dj140/X_driver/bldc_motor_cntroller/bldc_motor_cntroller.kicad_pcb

## KiCad design bldc_motor_cntroller/bldc_motor_cntroller.kicad_pcb (2021-05-30)

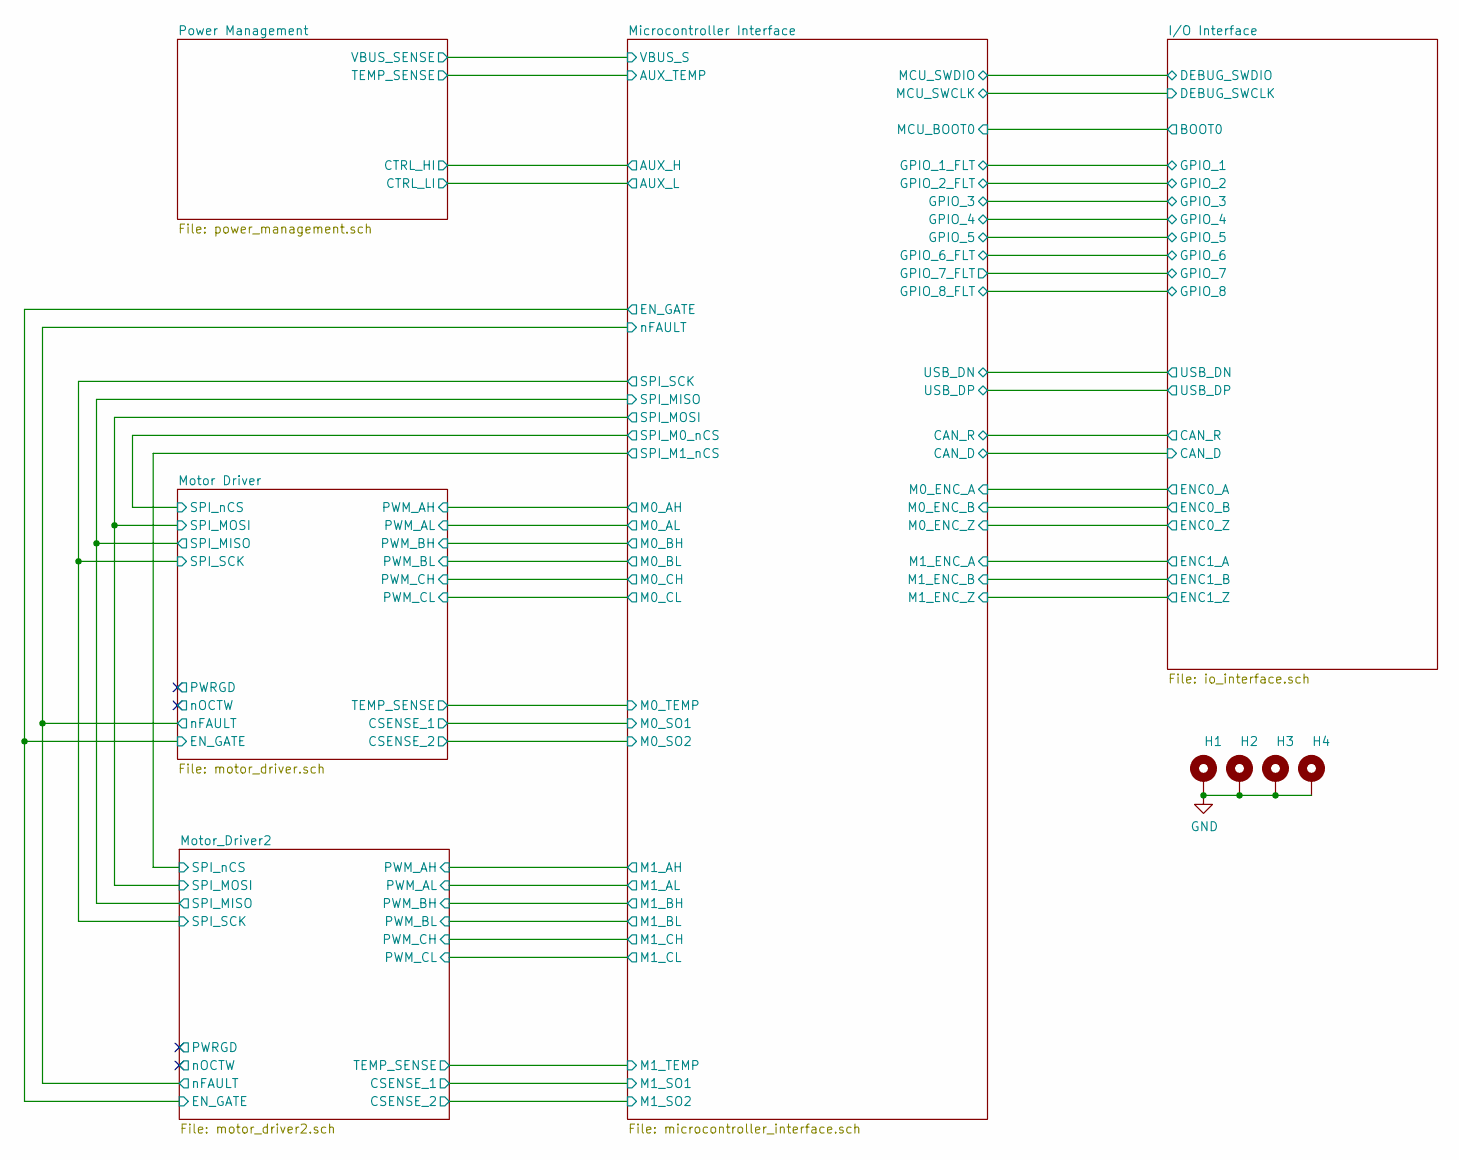
[picture p1: schematic bldc_motor_cntroller.sch, X_Odrive]

Parts:
H1, H2, H3, H4: MountingHole_Pad; MountingHole_2.2mm_M2_Pad_Via

Connections:
GND: H1.1, H2.1, H3.1, H4.1; also elsewhere on the board

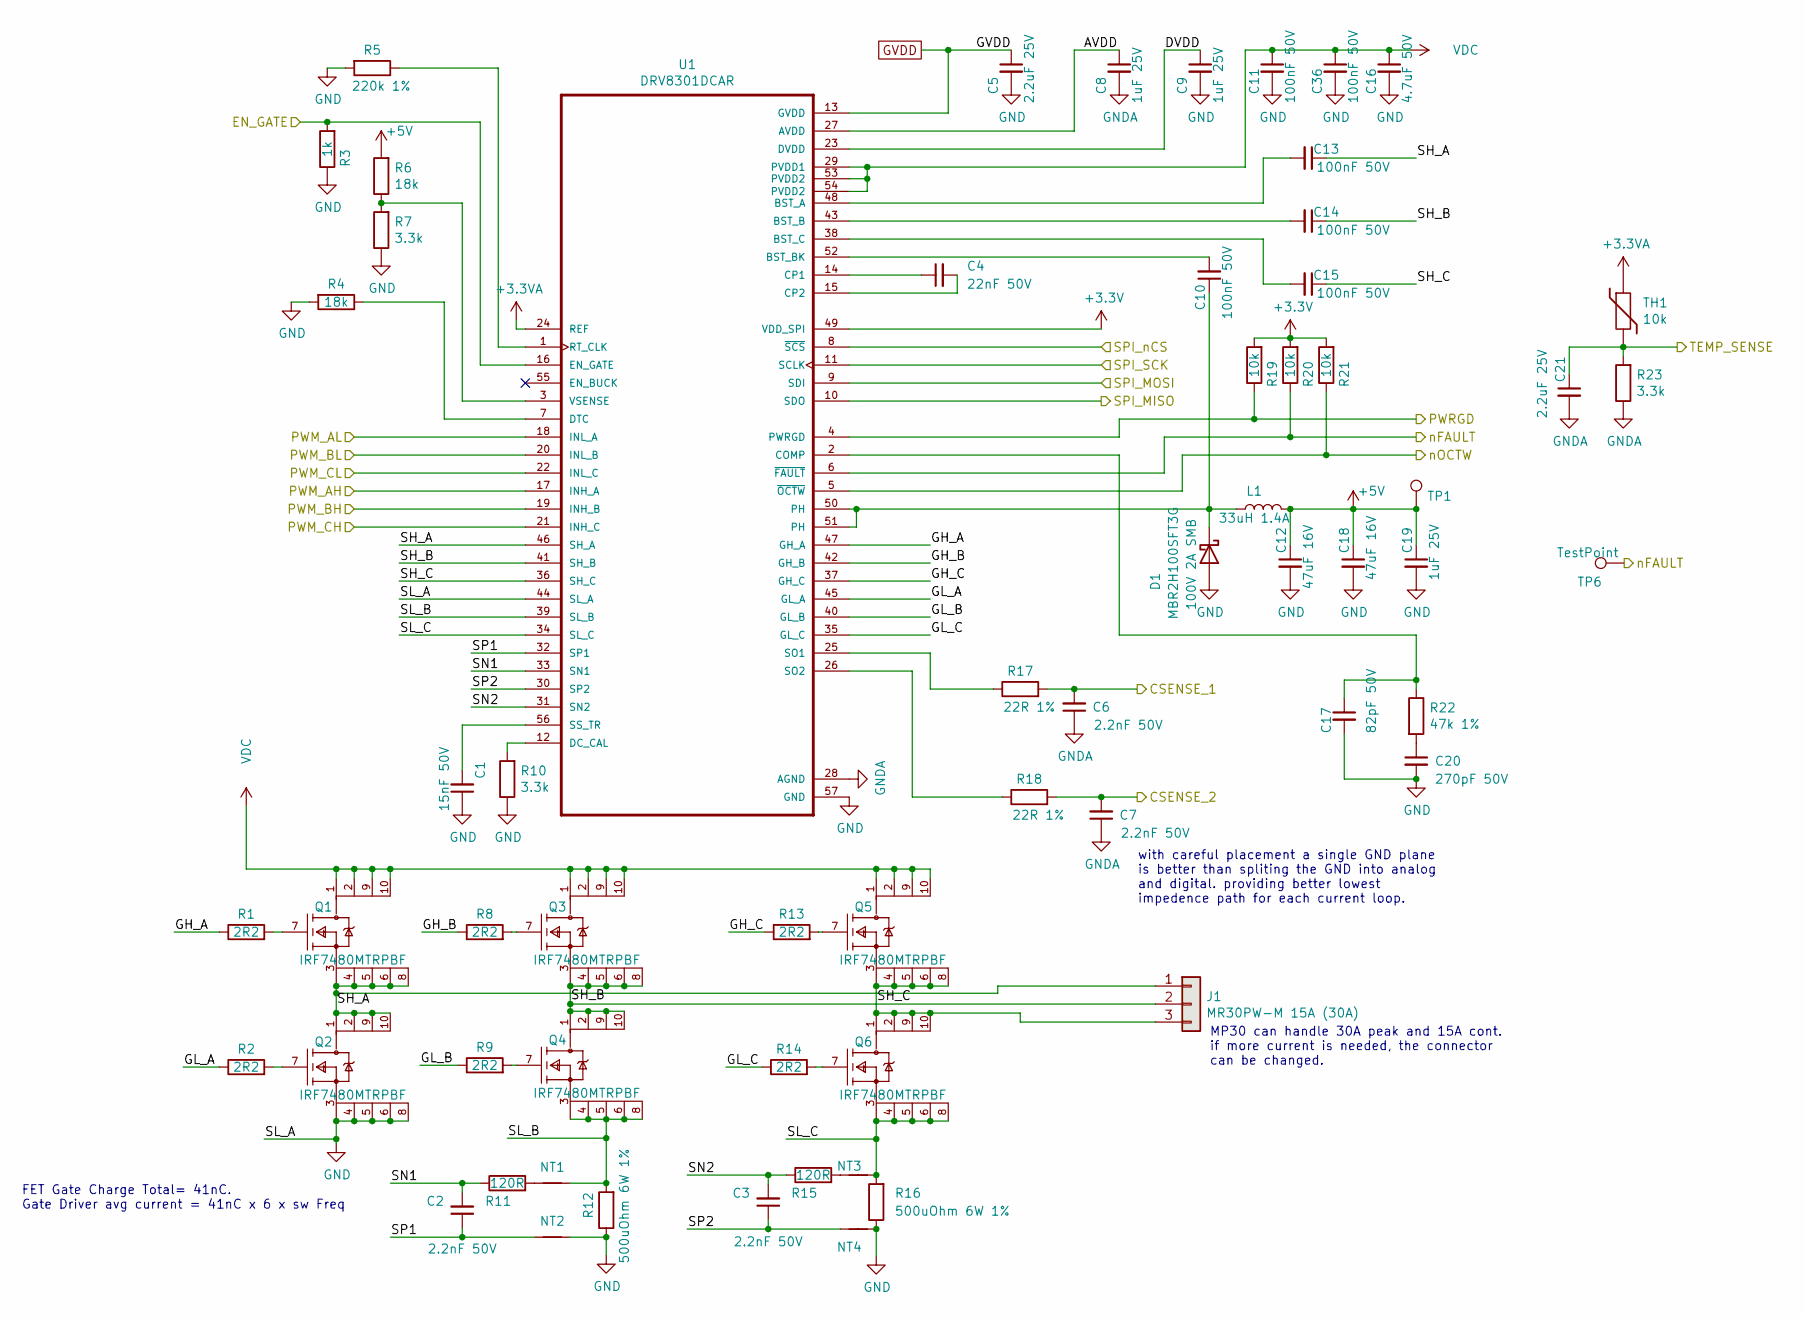
[picture p2: schematic motor_driver.sch, Motor Driver]

Parts:
C1: 15nF 50V; C_0402_1005Metric; MPN GCM155R71E153JA55D
C2, C3, C6, C7: 2.2nF 50V; C_0402_1005Metric; MPN C0402C222J3GEC7411; LCSC Part # C1531
C4: 22nF 50V; C_0402_1005Metric; MPN C0402C223K5REC7411; LCSC Part # C1532
C5, C21: 2.2uF 25V; C_0402_1005Metric; MPN GRM155C81E225KE11D; LCSC Part # C12530
C8, C9, C19: 1uF 25V; C_0402_1005Metric; MPN GMK105CC6105MV-F; LCSC Part # C52923
C10, C13, C14, C15: 100nF 50V; C_0402_1005Metric; MPN GCM155L8EH104KE07D
C11, C36: 100nF 50V; C_0402_1005Metric; MPN GRM155R62A104KE14D
C12, C18: 47uF 16V; C_1206_3216Metric; MPN GRM32EC81C476KE15L; LCSC Part # C96123
C16: 4.7uF 50V; C_1206_3216Metric; MPN HMK325C7475KN-TE
C17: 82pF 50V; C_0402_1005Metric; MPN VJ0402A820JXACW1BC
C20: 270pF 50V; C_0402_1005Metric; MPN GRM1555C1H271FA01D
D1: 100V 2A SMB; D_SOD-123F; MPN MBR2H100SFT3G
J1: MR30PW-M 15A (30A); AMASS_MR30PW-M_1x03_P3.50mm_Horizontal
L1: 33uH 1.4A; L_Taiyo-Yuden_NR-60xx; MPN NR6045T330M
NT1, NT2, NT3, NT4: Net-Tie_2; NetTie-2_SMD_Pad0.5mm
Q1, Q2, Q3, Q4, Q5, Q6: IRF7480MTRPBF; Infineon-MG-WDSON-8-05_2016-901-MFG; mouser part number 942-IRF7480MTRPBF; digikey description MOSFET N-CH 40V 217A DIRECTFET
R1, R2, R8, R9, R13, R14: 2R2; R_0402_1005Metric; MPN CRCW04022R20FKEDC
R3: 1k; R_0402_1005Metric; MPN ERJ-2RKF1001X; LCSC Part # C11702
R4, R6: 18k; R_0402_1005Metric; MPN CRCW040218K0FKED; LCSC Part # C25762
R5: 220k 1%; R_0402_1005Metric; MPN CRCW0402220KFKEDC; LCSC Part # C25767
R7, R10, R23: 3.3k; R_0402_1005Metric; MPN CRCW04023K30FKEDC; LCSC Part # C25890
R11, R15: 120R; R_0402_1005Metric; MPN ERJ-2RKF1200X; LCSC Part # C25079
R12, R16: 500uOhm 6W 1%; R_2512_6332Metric; MPN CSS2H-2512R-L500F
R17, R18: 22R 1%; R_0402_1005Metric; MPN CRCW040222R0FKEDC; LCSC Part # C25092
R19, R20, R21: 10k; R_0402_1005Metric; MPN CRCW040210K0FKEDC; LCSC Part # C25744
R22: 47k 1%; R_0402_1005Metric; MPN CRGP0402F47K; LCSC Part # C25792
TH1: 10k; R_0402_1005Metric; MPN CRCW040210K0FKEDC
TP1, TP6: TestPoint; TestPoint_Pad_D1.0mm
U1: DRV8301DCAR; DRV8301DCA; MPN DRV8301DCAR

Connections:
+3.3VA: TH1.1, U1.24 (REF); also elsewhere on the board
+3V3: R19.2, R20.2, R21.2, U1.49 (VDD_SPI); also elsewhere on the board
+5V: C12.1, C18.1, C19.1, L1.2, R6.2, TP1.1; also elsewhere on the board
/Microcontroller Interface/EN_GATE: R3.2, U1.16 (EN_GATE); also elsewhere on the board
/Microcontroller Interface/M0_AH: U1.17 (INH_A); also elsewhere on the board
/Microcontroller Interface/M0_AL: U1.18 (INL_A); also elsewhere on the board
/Microcontroller Interface/M0_BH: U1.19 (INH_B); also elsewhere on the board
/Microcontroller Interface/M0_BL: U1.20 (INL_B); also elsewhere on the board
/Microcontroller Interface/M0_CH: U1.21 (INH_C); also elsewhere on the board
/Microcontroller Interface/M0_CL: U1.22 (INL_C); also elsewhere on the board
/Microcontroller Interface/M0_TEMP: C21.1, R23.2, TH1.2; also elsewhere on the board
/Microcontroller Interface/SPI_M0_nCS: U1.8 (~SCS~); also elsewhere on the board
/Microcontroller Interface/SPI_MISO: U1.10 (SDO); also elsewhere on the board
/Microcontroller Interface/SPI_MOSI: U1.9 (SDI); also elsewhere on the board
/Microcontroller Interface/SPI_SCK: U1.11 (SCLK); also elsewhere on the board
/Microcontroller Interface/nFAULT: R20.1, TP6.1, U1.6 (~FAULT~); also elsewhere on the board
/Motor Driver/AVDD: C8.1, U1.27 (AVDD)
/Motor Driver/CSENSE_1: C6.2, R17.2; also elsewhere on the board
/Motor Driver/CSENSE_2: C7.2, R18.2; also elsewhere on the board
/Motor Driver/DVDD: C9.1, U1.23 (DVDD)
/Motor Driver/GH_A: R1.1, U1.47 (GH_A)
/Motor Driver/GH_B: R8.1, U1.42 (GH_B)
/Motor Driver/GH_C: R13.1, U1.37 (GH_C)
/Motor Driver/GL_A: R2.1, U1.45 (GL_A)
/Motor Driver/GL_B: R9.1, U1.40 (GL_B)
/Motor Driver/GL_C: R14.1, U1.35 (GL_C)
/Motor Driver/PWRGD: R19.1, U1.4 (PWRGD)
/Motor Driver/SH_A: C13.1, J1.1, Q1.3 (S), Q1.4 (S), Q1.5 (S), Q1.6 (S), Q1.8 (S), Q2.1 (D), Q2.2 (D), Q2.9 (D), Q2.10 (D), U1.46 (SH_A)
/Motor Driver/SH_B: C14.1, J1.2, Q3.3 (S), Q3.4 (S), Q3.5 (S), Q3.6 (S), Q3.8 (S), Q4.1 (D), Q4.2 (D), Q4.9 (D), Q4.10 (D), U1.41 (SH_B)
/Motor Driver/SH_C: C15.1, J1.3, Q5.3 (S), Q5.4 (S), Q5.5 (S), Q5.6 (S), Q5.8 (S), Q6.1 (D), Q6.2 (D), Q6.9 (D), Q6.10 (D), U1.36 (SH_C)
/Motor Driver/SL_B: NT1.2, Q4.3 (S), Q4.4 (S), Q4.5 (S), Q4.6 (S), Q4.8 (S), R12.2, U1.39 (SL_B)
/Motor Driver/SL_C: NT3.2, Q6.3 (S), Q6.4 (S), Q6.5 (S), Q6.6 (S), Q6.8 (S), R16.2, U1.34 (SL_C)
/Motor Driver/SN1: C2.2, R11.1, U1.33 (SN1)
/Motor Driver/SN2: C3.2, R15.1, U1.31 (SN2)
/Motor Driver/SP1: C2.1, NT2.1, U1.32 (SP1)
/Motor Driver/SP2: C3.1, NT4.1, U1.30 (SP2)
/Motor Driver/nOCTW: R21.1, U1.5 (~OCTW~)
GND: C1.1, C5.2, C6.1, C7.1, C8.2, C9.2, C11.2, C12.2, C16.2, C17.2, C18.2, C19.2, C20.2, C21.2, C36.2, D1.2 (A), NT2.2, NT4.2, Q2.3 (S), Q2.4 (S), Q2.5 (S), Q2.6 (S), Q2.8 (S), R3.1, R4.2, R5.2, R7.1, R10.1, R12.1, R16.1, R23.1, U1.28 (AGND), U1.44 (SL_A), U1.57 (GND), U1.V; also elsewhere on the board
GVDD: C5.1, U1.13 (GVDD); also elsewhere on the board
unnamed: C1.2, U1.56 (SS_TR)
unnamed: C4.1, U1.14 (CP1)
unnamed: C4.2, U1.15 (CP2)
unnamed: C10.1, D1.1 (K), L1.1, U1.50 (PH), U1.51 (PH)
unnamed: C10.2, U1.52 (BST_BK)
unnamed: C13.2, U1.48 (BST_A)
unnamed: C14.2, U1.43 (BST_B)
unnamed: C15.2, U1.38 (BST_C)
unnamed: C17.1, R22.1, U1.2 (COMP)
unnamed: C20.1, R22.2
unnamed: NT1.1, R11.2
unnamed: NT3.1, R15.2
unnamed: Q1.7 (G), R1.2
unnamed: Q2.7 (G), R2.2
unnamed: Q3.7 (G), R8.2
unnamed: Q4.7 (G), R9.2
unnamed: Q5.7 (G), R13.2
unnamed: Q6.7 (G), R14.2
unnamed: R4.1, U1.7 (DTC)
unnamed: R5.1, U1.1 (RT_CLK)
unnamed: R6.1, R7.2, U1.3 (VSENSE)
unnamed: R10.2, U1.12 (DC_CAL)
unnamed: R17.1, U1.25 (SO1)
unnamed: R18.1, U1.26 (SO2)
VDC: C11.1, C16.1, C36.1, Q1.1 (D), Q1.2 (D), Q1.9 (D), Q1.10 (D), Q3.1 (D), Q3.2 (D), Q3.9 (D), Q3.10 (D), Q5.1 (D), Q5.2 (D), Q5.9 (D), Q5.10 (D), U1.29 (PVDD1), U1.53 (PVDD2), U1.54 (PVDD2); also elsewhere on the board

Notes on the sheet:
with careful placement a single GND plane is better than spliting the GND into analog and digital. providing better lowest impedence path for each current loop.
FET Gate Charge Total= 41nC. Gate Driver avg current = 41nC x 6 x sw Freq
MP30 can handle 30A peak and 15A cont. if more current is needed, the connector can be changed.

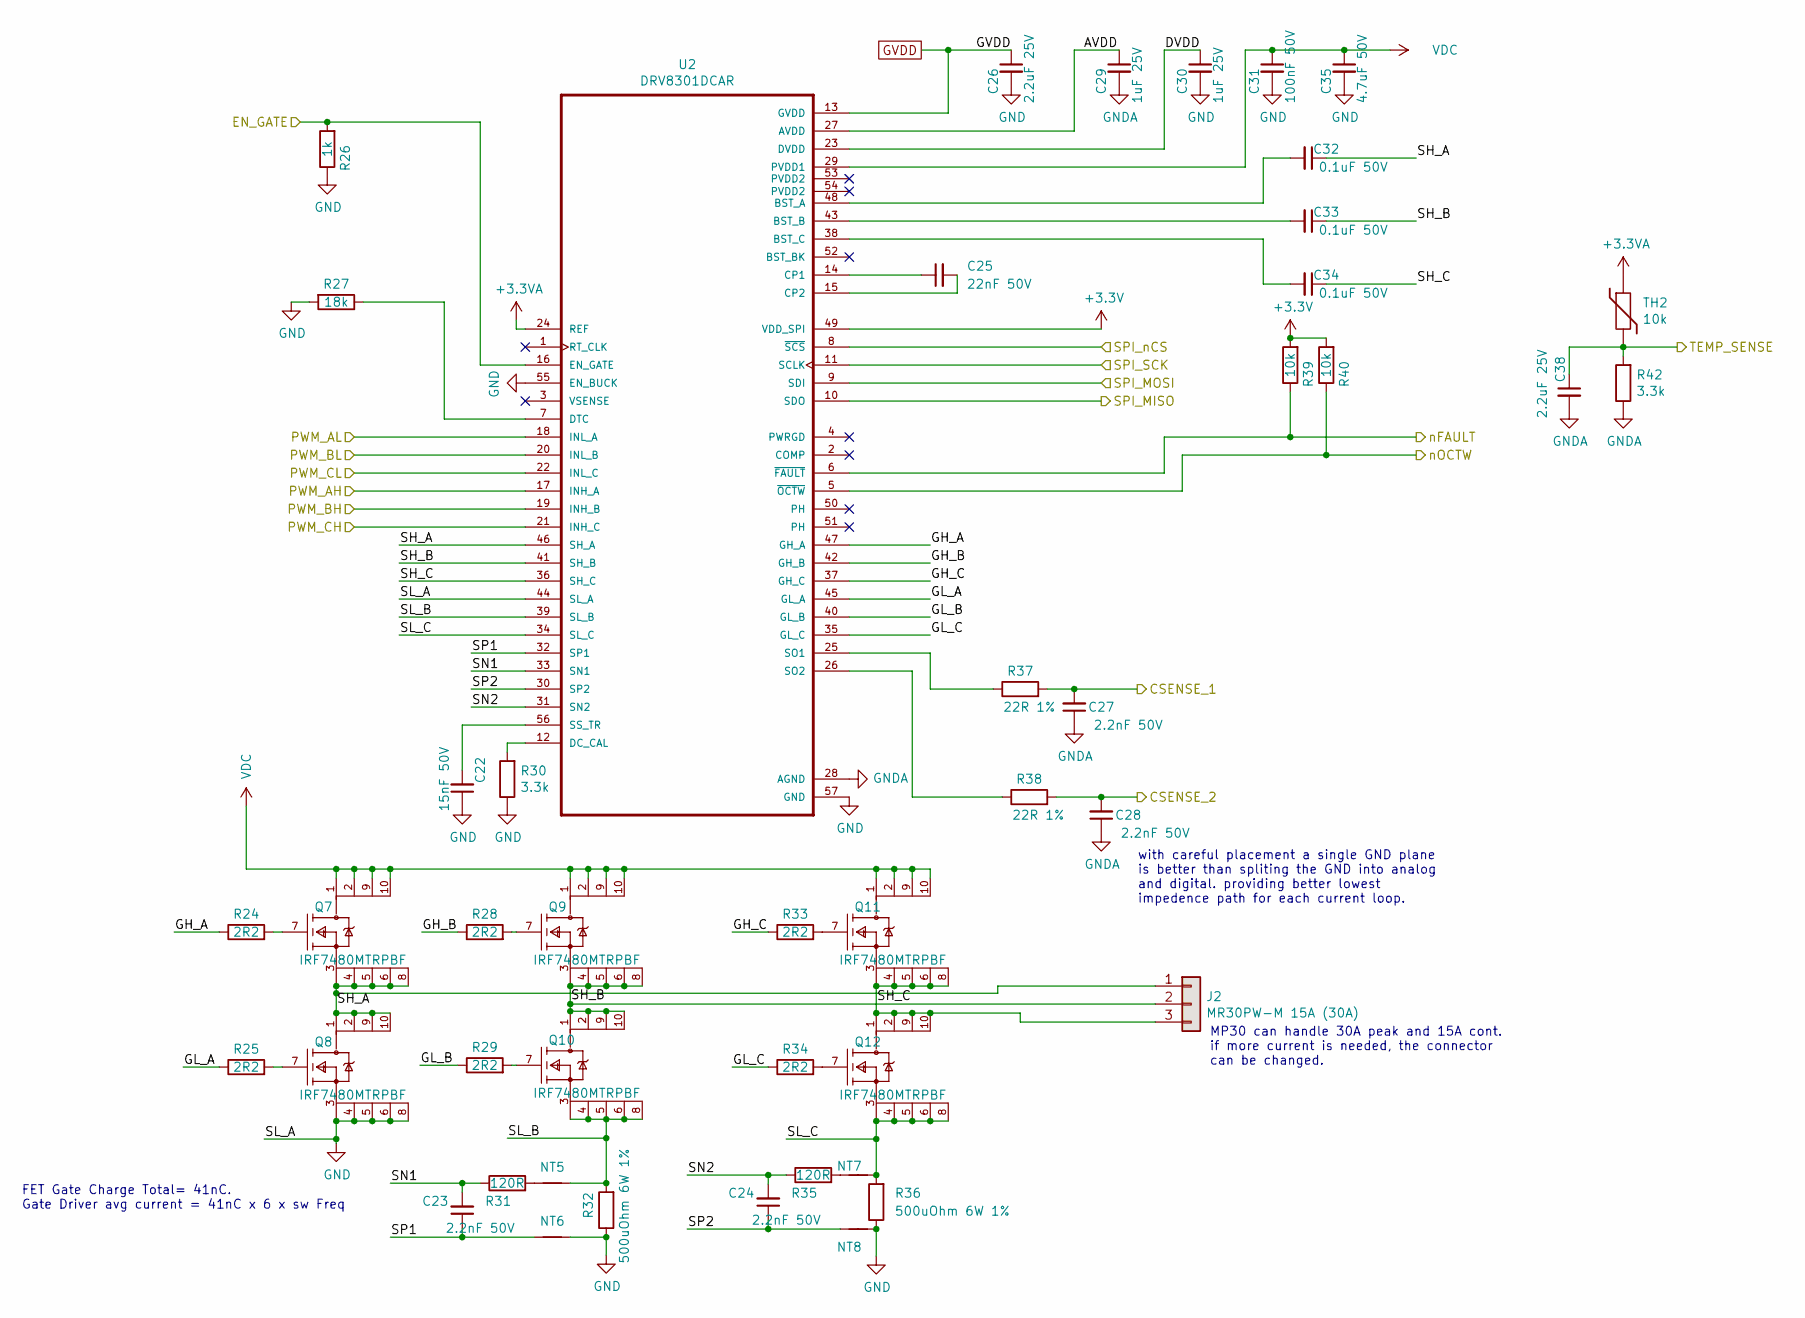
[picture p3: schematic motor_driver2.sch, Motor Driver]

Parts:
C22: 15nF 50V; C_0402_1005Metric; MPN GCM155R71E153JA55D
C23, C24, C27, C28: 2.2nF 50V; C_0402_1005Metric; MPN C0402C222J3GEC7411; LCSC Part # C1531
C25: 22nF 50V; C_0402_1005Metric; MPN C0402C223K5REC7411; LCSC Part # C1532
C26, C38: 2.2uF 25V; C_0402_1005Metric; MPN GRM155C81E225KE11D; LCSC Part # C12530
C29, C30: 1uF 25V; C_0402_1005Metric; MPN GMK105CC6105MV-F; LCSC Part # C52923
C31: 100nF 50V; C_0402_1005Metric; MPN GRM155R62A104KE14D
C32, C33, C34: 0.1uF 50V; C_0402_1005Metric; MPN GCM155L8EH104KE07D
C35: 4.7uF 50V; C_1206_3216Metric; MPN HMK325C7475KN-TE
J2: MR30PW-M 15A (30A); AMASS_MR30PW-M_1x03_P3.50mm_Horizontal
NT5, NT6, NT7, NT8: Net-Tie_2; NetTie-2_SMD_Pad0.5mm
Q7, Q8, Q9, Q10, Q11, Q12: IRF7480MTRPBF; Infineon-MG-WDSON-8-05_2016-901-MFG; mouser part number 942-IRF7480MTRPBF; digikey description MOSFET N-CH 40V 217A DIRECTFET
R24, R25, R28, R29, R33, R34: 2R2; R_0402_1005Metric; MPN CRCW04022R20FKEDC
R26: 1k; R_0402_1005Metric; MPN ERJ-2RKF1001X; LCSC Part # C11702
R27: 18k; R_0402_1005Metric; MPN CRCW040218K0FKED; LCSC Part # C25762
R30, R42: 3.3k; R_0402_1005Metric; MPN CRCW04023K30FKEDC; LCSC Part # C25890
R31, R35: 120R; R_0402_1005Metric; MPN ERJ-2RKF1200X; LCSC Part # C25079
R32, R36: 500uOhm 6W 1%; R_2512_6332Metric; MPN CSS2H-2512R-L500F
R37, R38: 22R 1%; R_0402_1005Metric; MPN CRCW040222R0FKEDC; LCSC Part # C25092
R39, R40: 10k; R_0402_1005Metric; MPN CRCW040210K0FKEDC; LCSC Part # C25744
TH2: 10k; R_0402_1005Metric; MPN CRCW040210K0FKEDC
U2: DRV8301DCAR; DRV8301DCA; MPN DRV8301DCAR

Connections:
+3.3VA: TH2.1, U2.24 (REF); also elsewhere on the board
+3V3: R39.2, R40.2, U2.49 (VDD_SPI); also elsewhere on the board
/Microcontroller Interface/EN_GATE: R26.2, U2.16 (EN_GATE); also elsewhere on the board
/Microcontroller Interface/M1_AH: U2.17 (INH_A); also elsewhere on the board
/Microcontroller Interface/M1_AL: U2.18 (INL_A); also elsewhere on the board
/Microcontroller Interface/M1_BH: U2.19 (INH_B); also elsewhere on the board
/Microcontroller Interface/M1_BL: U2.20 (INL_B); also elsewhere on the board
/Microcontroller Interface/M1_CH: U2.21 (INH_C); also elsewhere on the board
/Microcontroller Interface/M1_CL: U2.22 (INL_C); also elsewhere on the board
/Microcontroller Interface/M1_TEMP: C38.1, R42.2, TH2.2; also elsewhere on the board
/Microcontroller Interface/SPI_M1_nCS: U2.8 (~SCS~); also elsewhere on the board
/Microcontroller Interface/SPI_MISO: U2.10 (SDO); also elsewhere on the board
/Microcontroller Interface/SPI_MOSI: U2.9 (SDI); also elsewhere on the board
/Microcontroller Interface/SPI_SCK: U2.11 (SCLK); also elsewhere on the board
/Microcontroller Interface/nFAULT: R39.1, U2.6 (~FAULT~); also elsewhere on the board
/Motor_Driver2/AVDD: C29.1, U2.27 (AVDD)
/Motor_Driver2/CSENSE_1: C27.2, R37.2; also elsewhere on the board
/Motor_Driver2/CSENSE_2: C28.2, R38.2; also elsewhere on the board
/Motor_Driver2/DVDD: C30.1, U2.23 (DVDD)
/Motor_Driver2/GH_A: R24.1, U2.47 (GH_A)
/Motor_Driver2/GH_B: R28.1, U2.42 (GH_B)
/Motor_Driver2/GH_C: R33.1, U2.37 (GH_C)
/Motor_Driver2/GL_A: R25.1, U2.45 (GL_A)
/Motor_Driver2/GL_B: R29.1, U2.40 (GL_B)
/Motor_Driver2/GL_C: R34.1, U2.35 (GL_C)
/Motor_Driver2/SH_A: C32.1, J2.1, Q7.3 (S), Q7.4 (S), Q7.5 (S), Q7.6 (S), Q7.8 (S), Q8.1 (D), Q8.2 (D), Q8.9 (D), Q8.10 (D), U2.46 (SH_A)
/Motor_Driver2/SH_B: C33.1, J2.2, Q9.3 (S), Q9.4 (S), Q9.5 (S), Q9.6 (S), Q9.8 (S), Q10.1 (D), Q10.2 (D), Q10.9 (D), Q10.10 (D), U2.41 (SH_B)
/Motor_Driver2/SH_C: C34.1, J2.3, Q11.3 (S), Q11.4 (S), Q11.5 (S), Q11.6 (S), Q11.8 (S), Q12.1 (D), Q12.2 (D), Q12.9 (D), Q12.10 (D), U2.36 (SH_C)
/Motor_Driver2/SL_B: NT5.2, Q10.3 (S), Q10.4 (S), Q10.5 (S), Q10.6 (S), Q10.8 (S), R32.2, U2.39 (SL_B)
/Motor_Driver2/SL_C: NT7.2, Q12.3 (S), Q12.4 (S), Q12.5 (S), Q12.6 (S), Q12.8 (S), R36.2, U2.34 (SL_C)
/Motor_Driver2/SN1: C23.2, R31.1, U2.33 (SN1)
/Motor_Driver2/SN2: C24.2, R35.1, U2.31 (SN2)
/Motor_Driver2/SP1: C23.1, NT6.1, U2.32 (SP1)
/Motor_Driver2/SP2: C24.1, NT8.1, U2.30 (SP2)
/Motor_Driver2/nOCTW: R40.1, U2.5 (~OCTW~)
GND: C22.1, C26.2, C27.1, C28.1, C29.2, C30.2, C31.2, C35.2, C38.2, NT6.2, NT8.2, Q8.3 (S), Q8.4 (S), Q8.5 (S), Q8.6 (S), Q8.8 (S), R26.1, R27.2, R30.1, R32.1, R36.1, R42.1, U2.28 (AGND), U2.44 (SL_A), U2.55 (EN_BUCK), U2.57 (GND), U2.V; also elsewhere on the board
GVDD: C26.1, U2.13 (GVDD); also elsewhere on the board
unnamed: C22.2, U2.56 (SS_TR)
unnamed: C25.1, U2.14 (CP1)
unnamed: C25.2, U2.15 (CP2)
unnamed: C32.2, U2.48 (BST_A)
unnamed: C33.2, U2.43 (BST_B)
unnamed: C34.2, U2.38 (BST_C)
unnamed: NT5.1, R31.2
unnamed: NT7.1, R35.2
unnamed: Q7.7 (G), R24.2
unnamed: Q8.7 (G), R25.2
unnamed: Q9.7 (G), R28.2
unnamed: Q10.7 (G), R29.2
unnamed: Q11.7 (G), R33.2
unnamed: Q12.7 (G), R34.2
unnamed: R27.1, U2.7 (DTC)
unnamed: R30.2, U2.12 (DC_CAL)
unnamed: R37.1, U2.25 (SO1)
unnamed: R38.1, U2.26 (SO2)
VDC: C31.1, C35.1, Q7.1 (D), Q7.2 (D), Q7.9 (D), Q7.10 (D), Q9.1 (D), Q9.2 (D), Q9.9 (D), Q9.10 (D), Q11.1 (D), Q11.2 (D), Q11.9 (D), Q11.10 (D), U2.29 (PVDD1); also elsewhere on the board

Notes on the sheet:
with careful placement a single GND plane is better than spliting the GND into analog and digital. providing better lowest impedence path for each current loop.
FET Gate Charge Total= 41nC. Gate Driver avg current = 41nC x 6 x sw Freq
MP30 can handle 30A peak and 15A cont. if more current is needed, the connector can be changed.

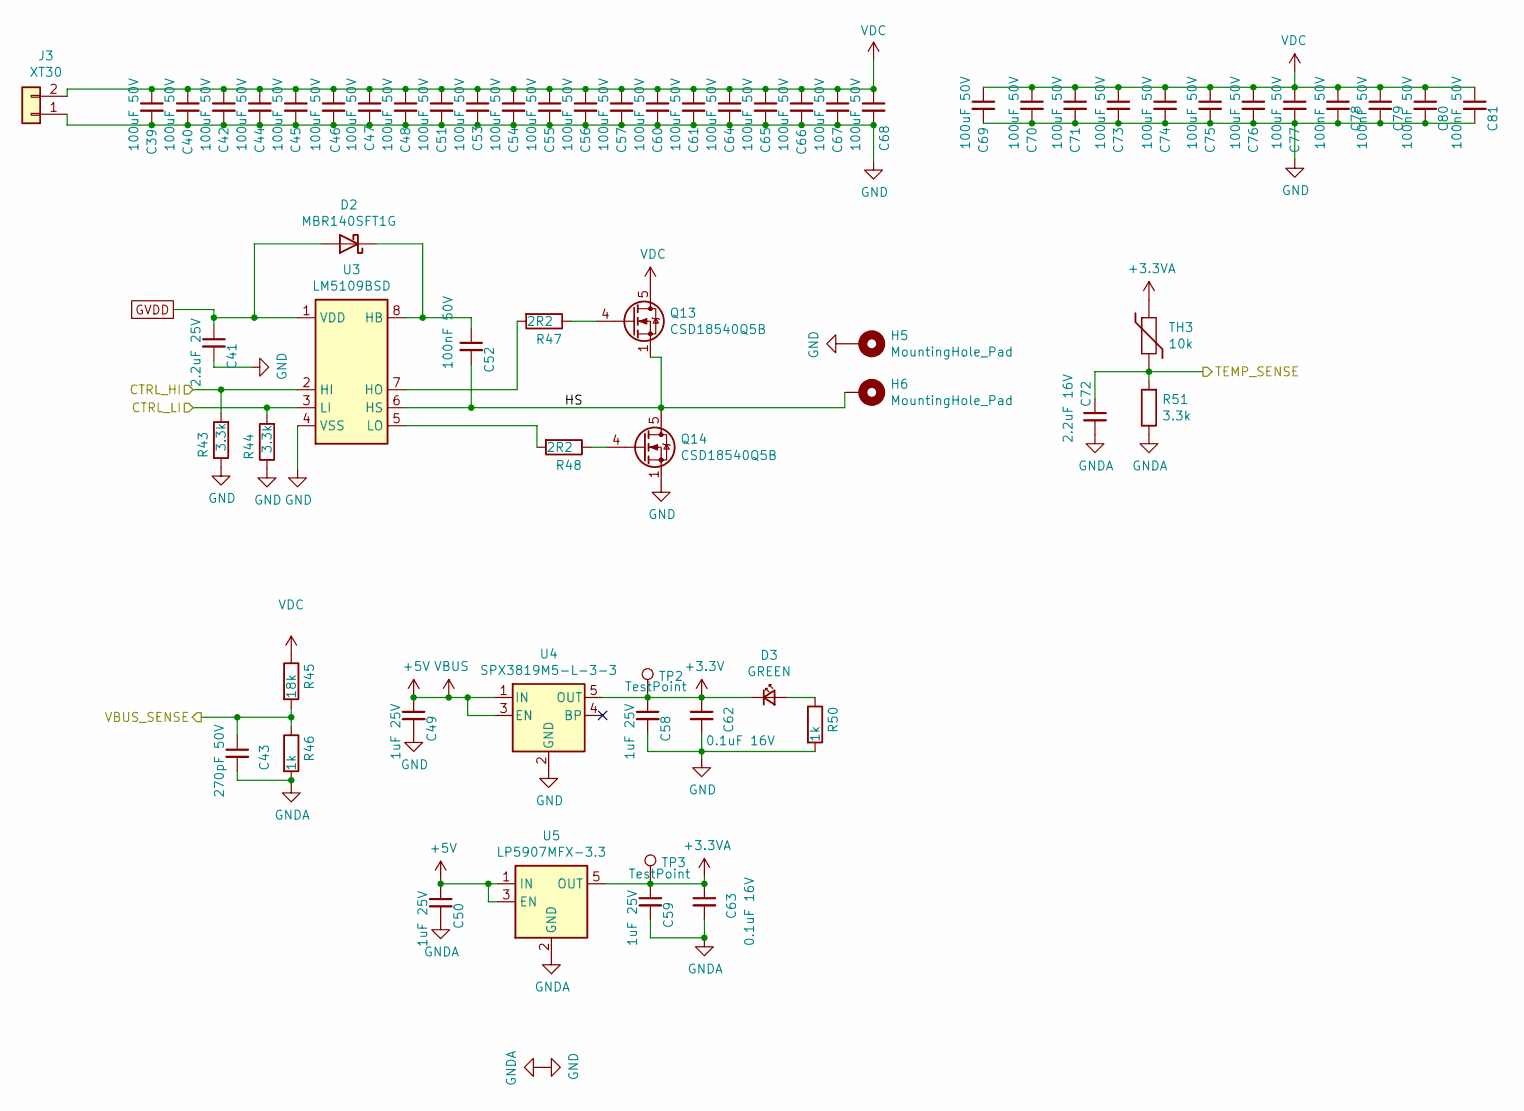
[picture p4: schematic power_management.sch, Power Management]

Parts:
C39, C40, C42, C44, C45, C46, C47, C48, C51, C53, C54, C55, C56, C57, C60, C61, C64, C65, C66, C67, C68, C69, C70, C71, C73, C74, C75, C76, C77: 100uF 50V; C_1206_3216Metric; MPN GMK105CC6105MV-F
C41: 2.2uF 25V; C_0402_1005Metric; MPN GMK105CC6105MV-F; LCSC Part # C12530
C43: 270pF 50V; C_0402_1005Metric; MPN GRM1555C1H271FA01D
C49, C50, C58, C59: 1uF 25V; C_0402_1005Metric; MPN GMK105CC6105MV-F; LCSC Part # C52923
C52: 100nF 50V; C_0402_1005Metric; MPN GMK105CC6105MV-F; LCSC Part # C1525
C62, C63: 0.1uF 16V; C_0402_1005Metric; MPN GRM155R62A104KE14D
C72: 2.2uF 16V; C_0402_1005Metric; MPN GRM155C81E225KE11D; LCSC Part # C12530
C78, C79, C80, C81: 100nF 50V; C_0402_1005Metric; MPN GMK105CC6105MV-F
D2: MBR140SFT1G; D_SOD-123F
D3: GREEN; LED_0402_1005Metric
H5, H6: MountingHole_Pad; TestPoint_Round
J3: XT30; AMASS_XT30PW-M_1x02_P2.50mm_Horizontal; MPN XT60
Q13, Q14: CSD18540Q5B; TDSON-8-1
R43, R44: 3.3k; R_0402_1005Metric; MPN CRCW040210K0FKEDC; LCSC Part # C25890
R45: 18k; R_0402_1005Metric; MPN CRCW040210K0FKEDC; LCSC Part # C25762
R46, R50: 1k; R_0402_1005Metric; MPN ERJ-2RKF1001X; LCSC Part # C11702
R47, R48: 2R2; R_0402_1005Metric; MPN CRCW040210K0FKEDC
R51: 3.3k; R_0402_1005Metric; MPN CRCW04023K30FKEDC; LCSC Part # C25890
TH3: 10k; R_0402_1005Metric; MPN CRCW040210K0FKEDC
TP2, TP3: TestPoint; TestPoint_Pad_D1.0mm
U3: LM5109BSD; WSON-8_4x4mm_P0.8mm
U4: SPX3819M5-L-3-3; SOT-23-5
U5: LP5907MFX-3.3; SOT-23-5

Connections:
+3.3VA: C59.1, C63.1, TH3.1, TP3.1, U5.5 (OUT); also elsewhere on the board
+3V3: C58.1, C62.1, D3.1 (K), TP2.1, U4.5 (OUT); also elsewhere on the board
+5V: C49.1, C50.1, U4.1 (IN), U4.3 (EN), U5.1 (IN), U5.3 (EN); also elsewhere on the board
/Microcontroller Interface/AUX_H: R43.2, U3.2 (HI); also elsewhere on the board
/Microcontroller Interface/AUX_L: R44.2, U3.3 (LI); also elsewhere on the board
/Microcontroller Interface/AUX_TEMP: C72.1, R51.2, TH3.2; also elsewhere on the board
/Microcontroller Interface/VBUS_S: C43.1, R45.2, R46.1; also elsewhere on the board
/Power Management/HS: C52.2, H6.1, Q13.1 (S), Q13.2 (S), Q13.3 (S), Q14.5 (D), U3.6 (HS)
GND: C39.2, C40.2, C41.2, C42.2, C43.2, C44.2, C45.2, C46.2, C47.2, C48.2, C49.2, C50.2, C51.2, C53.2, C54.2, C55.2, C56.2, C57.2, C58.2, C59.2, C60.2, C61.2, C62.2, C63.2, C64.2, C65.2, C66.2, C67.2, C68.2, C69.2, C70.2, C71.2, C72.2, C73.2, C74.2, C75.2, C76.2, C77.2, C78.2, C79.2, C80.2, C81.2, H5.1, J3.1, Q14.1 (S), Q14.2 (S), Q14.3 (S), R43.1, R44.1, R46.2, R50.2, R51.1, U3.4 (VSS), U3.9 (VSS), U4.2 (GND), U5.2 (GND); also elsewhere on the board
GVDD: C41.1, D2.2 (A), U3.1 (VDD); also elsewhere on the board
unnamed: C52.1, D2.1 (K), U3.8 (HB)
unnamed: D3.2 (A), R50.1
unnamed: Q13.4 (G), R47.1
unnamed: Q14.4 (G), R48.1
unnamed: R47.2, U3.7 (HO)
unnamed: R48.2, U3.5 (LO)
VDC: C39.1, C40.1, C42.1, C44.1, C45.1, C46.1, C47.1, C48.1, C51.1, C53.1, C54.1, C55.1, C56.1, C57.1, C60.1, C61.1, C64.1, C65.1, C66.1, C67.1, C68.1, C69.1, C70.1, C71.1, C73.1, C74.1, C75.1, C76.1, C77.1, C78.1, C79.1, C80.1, C81.1, J3.2, Q13.5 (D), R45.1; also elsewhere on the board

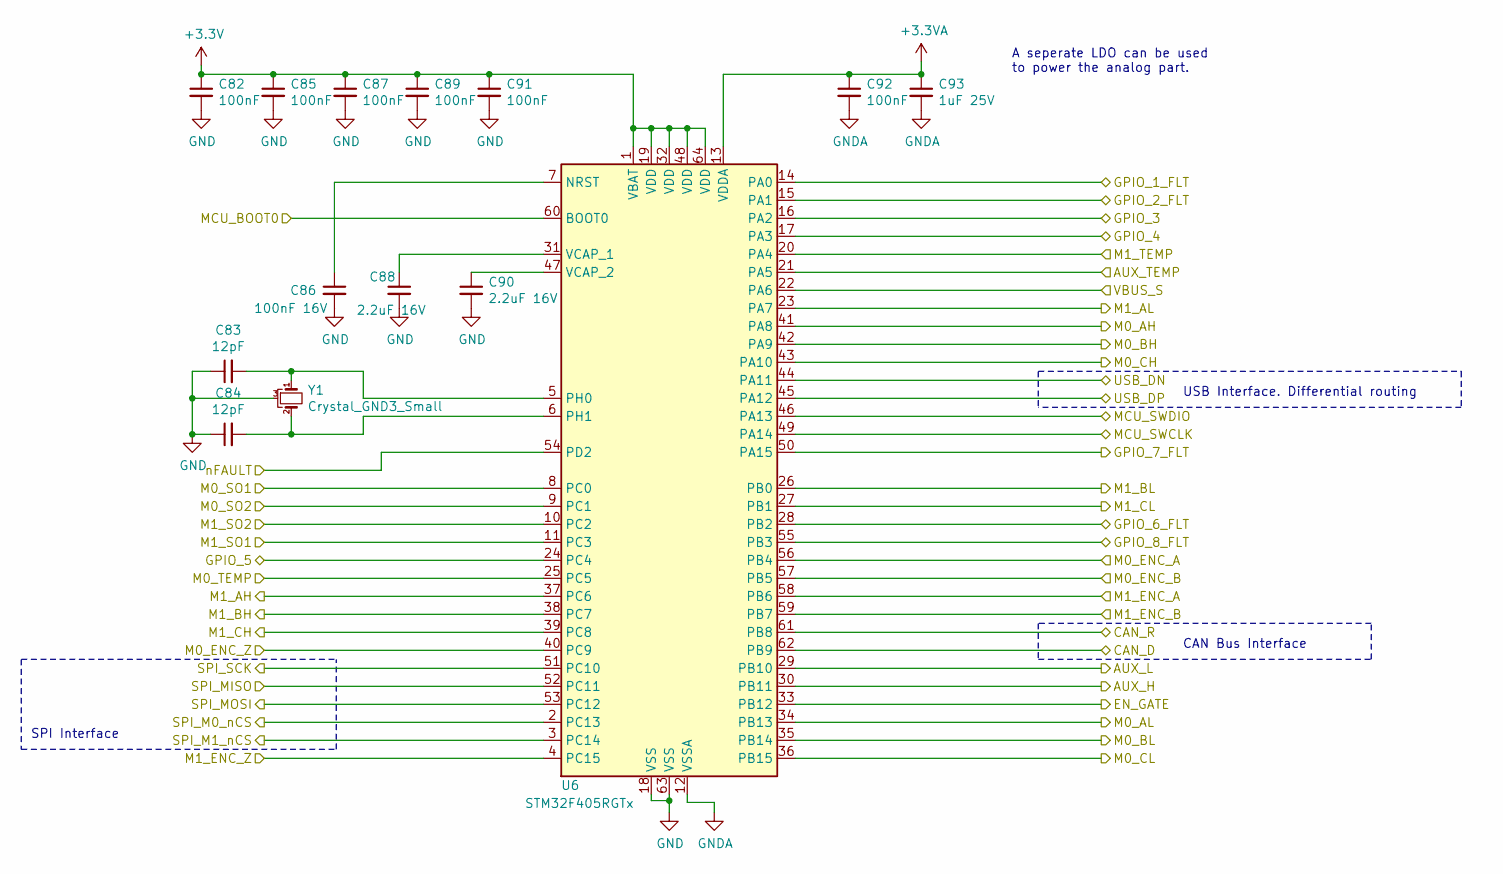
[picture p5: schematic microcontroller_interface.sch, Microcontroller Interface]

Parts:
C82, C85, C87, C89, C91, C92: 100nF; C_0402_1005Metric; MPN GRM155R62A104KE14D; LCSC Part # C1525
C83, C84: 12pF; C_0402_1005Metric; MPN GCQ1555C1H120FB01D; LCSC Part # C1547
C86: 100nF 16V; C_0402_1005Metric; MPN GRM155C81E225KE11D; LCSC Part # C1525
C88, C90: 2.2uF 16V; C_0402_1005Metric; MPN GRM155C81E225KE11D
C93: 1uF 25V; C_0402_1005Metric; MPN GMK105CC6105MV-F; LCSC Part # C52923
U6: STM32F405RGTx; LQFP-64_10x10mm_P0.5mm; MPN STM32F405RGT7
Y1: Crystal_GND3_Small; CSTCE8M00G55-R0

Connections:
+3.3VA: C92.1, C93.1, U6.13 (VDDA); also elsewhere on the board
+3V3: C82.1, C85.1, C87.1, C89.1, C91.1, U6.1 (VBAT), U6.19 (VDD), U6.32 (VDD), U6.48 (VDD), U6.64 (VDD); also elsewhere on the board
/I/O Interface/BOOT0: U6.60 (BOOT0); also elsewhere on the board
/I/O Interface/CAN_D: U6.62 (PB9); also elsewhere on the board
/I/O Interface/CAN_R: U6.61 (PB8); also elsewhere on the board
/I/O Interface/DEBUG_SWCLK: U6.49 (PA14); also elsewhere on the board
/I/O Interface/DEBUG_SWDIO: U6.46 (PA13); also elsewhere on the board
/I/O Interface/ENC0_A: U6.56 (PB4); also elsewhere on the board
/I/O Interface/ENC0_B: U6.57 (PB5); also elsewhere on the board
/I/O Interface/ENC0_Z: U6.40 (PC9); also elsewhere on the board
/I/O Interface/ENC1_A: U6.58 (PB6); also elsewhere on the board
/I/O Interface/ENC1_B: U6.59 (PB7); also elsewhere on the board
/I/O Interface/ENC1_Z: U6.4 (PC15); also elsewhere on the board
/I/O Interface/GPIO_1: U6.14 (PA0); also elsewhere on the board
/I/O Interface/GPIO_2: U6.15 (PA1); also elsewhere on the board
/I/O Interface/GPIO_3: U6.16 (PA2); also elsewhere on the board
/I/O Interface/GPIO_4: U6.17 (PA3); also elsewhere on the board
/I/O Interface/GPIO_5: U6.24 (PC4); also elsewhere on the board
/I/O Interface/GPIO_6: U6.28 (PB2); also elsewhere on the board
/I/O Interface/GPIO_7: U6.50 (PA15); also elsewhere on the board
/I/O Interface/GPIO_8: U6.55 (PB3); also elsewhere on the board
/I/O Interface/USB_DN: U6.44 (PA11); also elsewhere on the board
/I/O Interface/USB_DP: U6.45 (PA12); also elsewhere on the board
/Microcontroller Interface/AUX_H: U6.30 (PB11); also elsewhere on the board
/Microcontroller Interface/AUX_L: U6.29 (PB10); also elsewhere on the board
/Microcontroller Interface/AUX_TEMP: U6.21 (PA5); also elsewhere on the board
/Microcontroller Interface/EN_GATE: U6.33 (PB12); also elsewhere on the board
/Microcontroller Interface/M0_AH: U6.41 (PA8); also elsewhere on the board
/Microcontroller Interface/M0_AL: U6.34 (PB13); also elsewhere on the board
/Microcontroller Interface/M0_BH: U6.42 (PA9); also elsewhere on the board
/Microcontroller Interface/M0_BL: U6.35 (PB14); also elsewhere on the board
/Microcontroller Interface/M0_CH: U6.43 (PA10); also elsewhere on the board
/Microcontroller Interface/M0_CL: U6.36 (PB15); also elsewhere on the board
/Microcontroller Interface/M0_TEMP: U6.25 (PC5); also elsewhere on the board
/Microcontroller Interface/M1_AH: U6.37 (PC6); also elsewhere on the board
/Microcontroller Interface/M1_AL: U6.23 (PA7); also elsewhere on the board
/Microcontroller Interface/M1_BH: U6.38 (PC7); also elsewhere on the board
/Microcontroller Interface/M1_BL: U6.26 (PB0); also elsewhere on the board
/Microcontroller Interface/M1_CH: U6.39 (PC8); also elsewhere on the board
/Microcontroller Interface/M1_CL: U6.27 (PB1); also elsewhere on the board
/Microcontroller Interface/M1_TEMP: U6.20 (PA4); also elsewhere on the board
/Microcontroller Interface/SPI_M0_nCS: U6.2 (PC13); also elsewhere on the board
/Microcontroller Interface/SPI_M1_nCS: U6.3 (PC14); also elsewhere on the board
/Microcontroller Interface/SPI_MISO: U6.52 (PC11); also elsewhere on the board
/Microcontroller Interface/SPI_MOSI: U6.53 (PC12); also elsewhere on the board
/Microcontroller Interface/SPI_SCK: U6.51 (PC10); also elsewhere on the board
/Microcontroller Interface/VBUS_S: U6.22 (PA6); also elsewhere on the board
/Microcontroller Interface/nFAULT: U6.54 (PD2); also elsewhere on the board
/Motor Driver/CSENSE_1: U6.8 (PC0); also elsewhere on the board
/Motor Driver/CSENSE_2: U6.9 (PC1); also elsewhere on the board
/Motor_Driver2/CSENSE_1: U6.11 (PC3); also elsewhere on the board
/Motor_Driver2/CSENSE_2: U6.10 (PC2); also elsewhere on the board
GND: C82.2, C83.1, C84.1, C85.2, C86.2, C87.2, C88.2, C89.2, C90.2, C91.2, C92.2, C93.2, U6.12 (VSSA), U6.18 (VSS), U6.63 (VSS), Y1.3; also elsewhere on the board
unnamed: C83.2, U6.5 (PH0), Y1.1
unnamed: C84.2, U6.6 (PH1), Y1.2
unnamed: C86.1, U6.7 (NRST)
unnamed: C88.1, U6.31 (VCAP_1)
unnamed: C90.1, U6.47 (VCAP_2)

Notes on the sheet:
A seperate LDO can be used to power the analog part.
USB Interface. Differential routing
SPI Interface
CAN Bus Interface
