dj140/X_driver/bldc_motor_cntroller/bldc_motor_cntroller.kicad_pcb

## KiCad design bldc_motor_cntroller/bldc_motor_cntroller.kicad_pcb (continued)

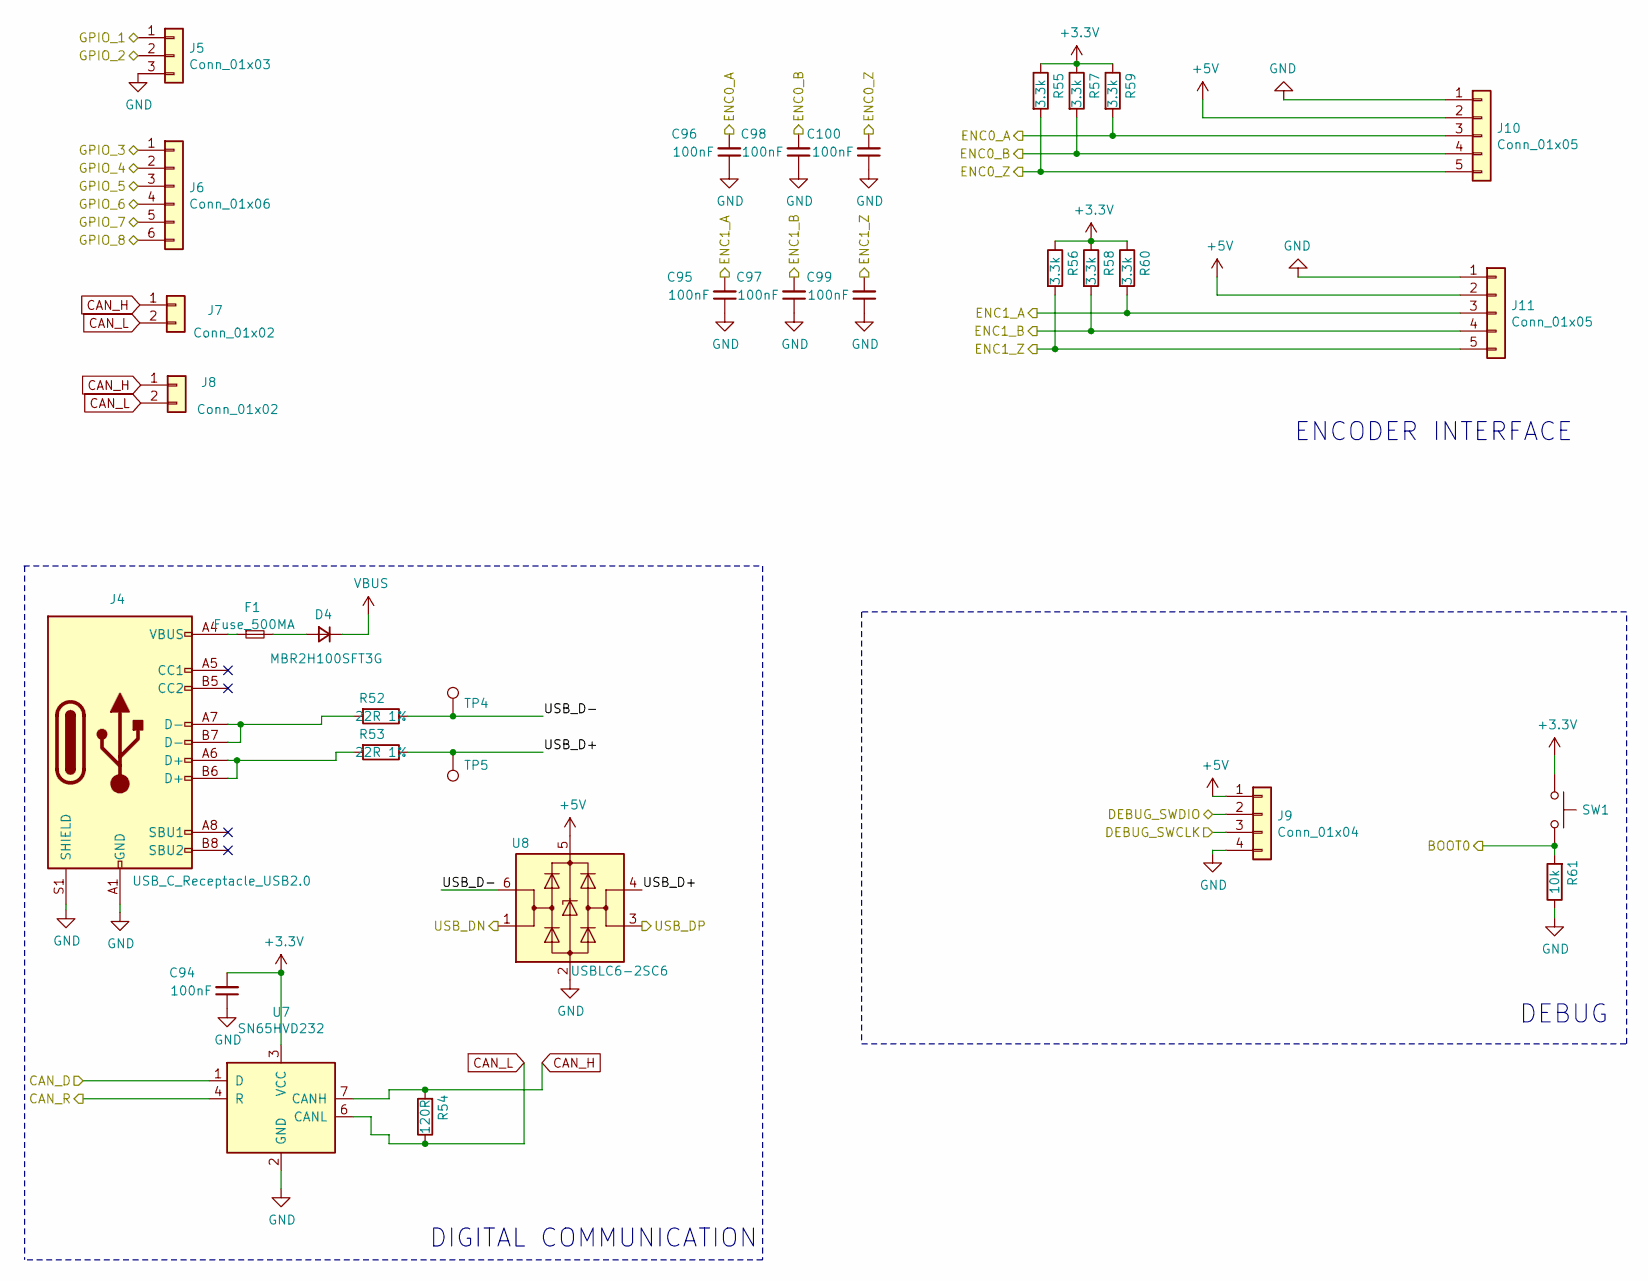
[picture p6: schematic io_interface.sch, I/O Interface]

Parts:
C94, C95, C96, C97, C98, C99, C100: 100nF; C_0402_1005Metric; MPN GRM155R62A104KE14D; LCSC Part # C1525
D4: MBR2H100SFT3G; D_SOD-123F
F1: Fuse_500MA; Fuse_1206_3216Metric
J4: USB_C_Receptacle_USB2.0; USB_C_Receptacle_HRO_TYPE-C-31-M-12
J5: Conn_01x03; JST_SH_SM03B-SRSS-TB_1x03-1MP_P1.00mm_Horizontal
J6: Conn_01x06; JST_SH_SM06B-SRSS-TB_1x06-1MP_P1.00mm_Horizontal
J7, J8: Conn_01x02; JST_SH_SM02B-SRSS-TB_1x02-1MP_P1.00mm_Horizontal
J9: Conn_01x04; JST_SH_SM04B-SRSS-TB_1x04-1MP_P1.00mm_Horizontal
J10, J11: Conn_01x05; JST_SH_SM05B-SRSS-TB_1x05-1MP_P1.00mm_Horizontal
R52, R53: 22R 1%; R_0402_1005Metric; MPN CRCW040222R0FKEDC; LCSC Part # C25092
R54: 120R; R_0402_1005Metric; MPN ERJ-2RKF1200X; LCSC Part # C25079
R55, R56, R57, R58, R59, R60: 3.3k; R_0402_1005Metric; MPN CRCW04023K30FKEDC; LCSC Part # C25890
R61: 10k; R_0402_1005Metric; MPN CRCW040210K0FKEDC; LCSC Part # C25744
SW1: B3U-1000P-B; SW_SPST_B3U-1000P; MPN B3U-1000P-B
TP4, TP5: TestPoint; TestPoint_Pad_D1.0mm
U7: SN65HVD232; SOIC-8_3.9x4.9mm_P1.27mm
U8: USBLC6-2SC6; SOT-23-6

Connections:
+3V3: C94.2, R55.1, R56.1, R57.1, R58.1, R59.1, R60.1, SW1.1, U7.3 (VCC); also elsewhere on the board
+5V: D4.1 (K), J9.1, J10.2, J11.2, U8.5 (VBUS); also elsewhere on the board
/I/O Interface/BOOT0: R61.2, SW1.2; also elsewhere on the board
/I/O Interface/CAN_D: U7.1 (D); also elsewhere on the board
/I/O Interface/CAN_R: U7.4 (R); also elsewhere on the board
/I/O Interface/DEBUG_SWCLK: J9.3; also elsewhere on the board
/I/O Interface/DEBUG_SWDIO: J9.2; also elsewhere on the board
/I/O Interface/ENC0_A: C96.2, J10.3, R59.2; also elsewhere on the board
/I/O Interface/ENC0_B: C98.2, J10.4, R57.2; also elsewhere on the board
/I/O Interface/ENC0_Z: C100.2, J10.5, R55.2; also elsewhere on the board
/I/O Interface/ENC1_A: C95.2, J11.3, R60.2; also elsewhere on the board
/I/O Interface/ENC1_B: C97.2, J11.4, R58.2; also elsewhere on the board
/I/O Interface/ENC1_Z: C99.2, J11.5, R56.2; also elsewhere on the board
/I/O Interface/GPIO_1: J5.1; also elsewhere on the board
/I/O Interface/GPIO_2: J5.2; also elsewhere on the board
/I/O Interface/GPIO_3: J6.1; also elsewhere on the board
/I/O Interface/GPIO_4: J6.2; also elsewhere on the board
/I/O Interface/GPIO_5: J6.3; also elsewhere on the board
/I/O Interface/GPIO_6: J6.4; also elsewhere on the board
/I/O Interface/GPIO_7: J6.5; also elsewhere on the board
/I/O Interface/GPIO_8: J6.6; also elsewhere on the board
/I/O Interface/USB_D+: R53.1, TP5.1, U8.4 (I/O2)
/I/O Interface/USB_D-: R52.1, TP4.1, U8.6 (I/O1)
/I/O Interface/USB_DN: U8.1 (I/O1); also elsewhere on the board
/I/O Interface/USB_DP: U8.3 (I/O2); also elsewhere on the board
CAN_H: J7.1, J8.1, R54.2, U7.7 (CANH)
CAN_L: J7.2, J8.2, R54.1, U7.6 (CANL)
GND: C94.1, C95.1, C96.1, C97.1, C98.1, C99.1, C100.1, J4.A1 (GND), J4.A12 (GND), J4.B1 (GND), J4.B12 (GND), J4.S1 (SHIELD), J5.3, J9.4, J10.1, J11.1, R61.1, U7.2 (GND), U8.2 (GND); also elsewhere on the board
unnamed: D4.2 (A), F1.2
unnamed: F1.1, J4.A4 (VBUS), J4.A9 (VBUS), J4.B4 (VBUS), J4.B9 (VBUS)
unnamed: J4.A6 (D+), J4.B6 (D+), R53.2
unnamed: J4.A7 (D-), J4.B7 (D-), R52.2

Notes on the sheet:
DIGITAL COMMUNICATION
DEBUG
ENCODER INTERFACE

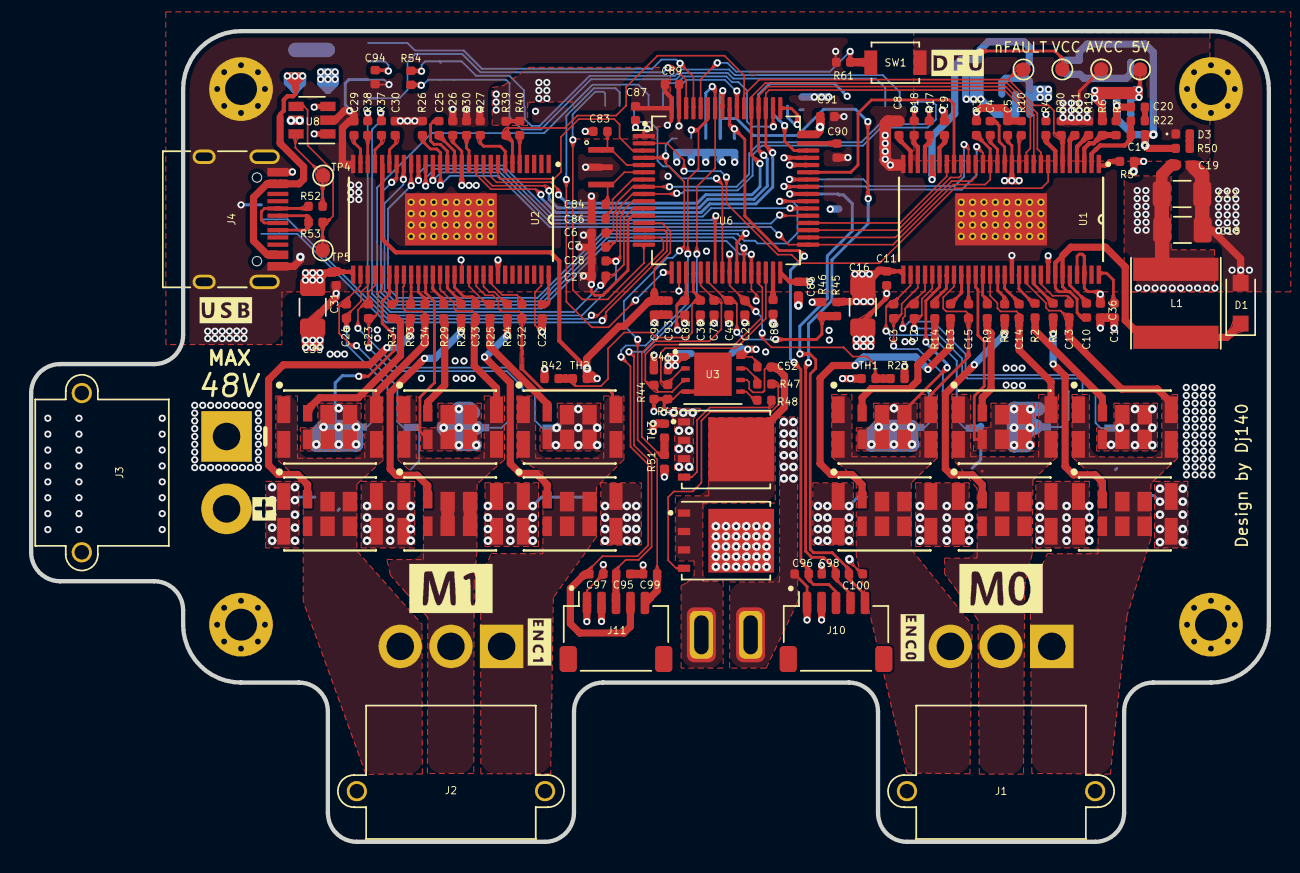
[picture p7: board bldc_motor_cntroller.kicad_pcb from above]

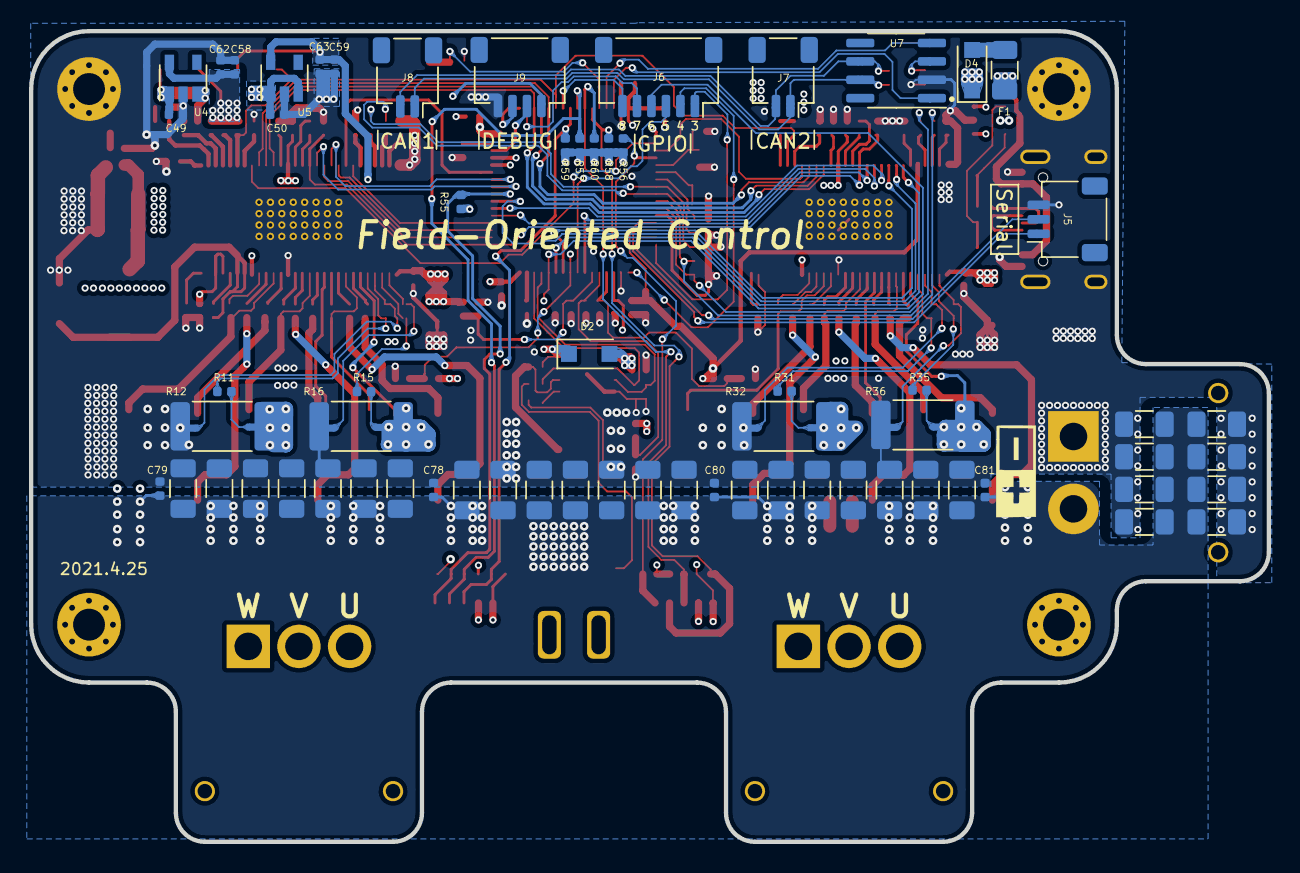
[picture p8: board bldc_motor_cntroller.kicad_pcb from below]

Board: 4 copper layers, 85.5 x 56.0 mm, 222 parts (72 on the bottom side), 155 nets.
